V2RetroComputing/analog-hardware/V2A-Rev1/Bill-of-Materials.md

|Qty|Designator|Item|Package|Description|
|---|---|---|---|---|
|9x|C1-C9|16V 100nF X7R|0402|Multilayer Ceramic Capacitor|
|1x|C11|25V 10uF X5R|0805|Multilayer Ceramic Capacitor|
|1x|C10|25V 22uF X5R|0805|Multilayer Ceramic Capacitor|
|1x|U7|AZ1117H-3.3|SOT-223|Fixed 3.3V regulator|
|1x|D1|SS14F|SMAF|40V 550mV @ 1A Shottkey Barrier Diode|
|3x|R12,R13,R14|10K Ohm 100mW|0402|10K Ohm 100mW Thin Film Resistor|
|3x|R3,R6,R9|2K Ohm 100mW|0402|2K Ohm 100mW Thin Film Resistor|
|3x|R2,R5,R8|1K Ohm 100mW|0402|1K Ohm 100mW Thin Film Resistor|
|3x|R1,R4,R7|470 Ohm 100mW|0402|470 Ohm 100mW Thin Film Resistor|
|2x|R10,R11|47 Ohm 100mW|0402|47 Ohm 100mW Thin Film Resistor|
|4x|U1-U4|SN74LVC8T245DGVR|TVSOP-24|Texas Instruments SN74LVC8T245DGVR Level Translating Transceiver|
|1x|U5|ATF16V8C-5JX|PLCC-20|Microchip ATF16V8C PLD|
|1x|U6|Pico-W|Module|Raspberry Pi Pico or Pico-W module (no pins)|
|1x|J2|VGA Connector|HD-15|High-Density D-SUB 15 VGA Connector|
