V2RetroComputing/analog-hardware/V2A-Rev1/V2-Analog-Rev1.kicad_pcb

## KiCad design V2A-Rev1/V2-Analog-Rev1.kicad_pcb (2023-04-17)

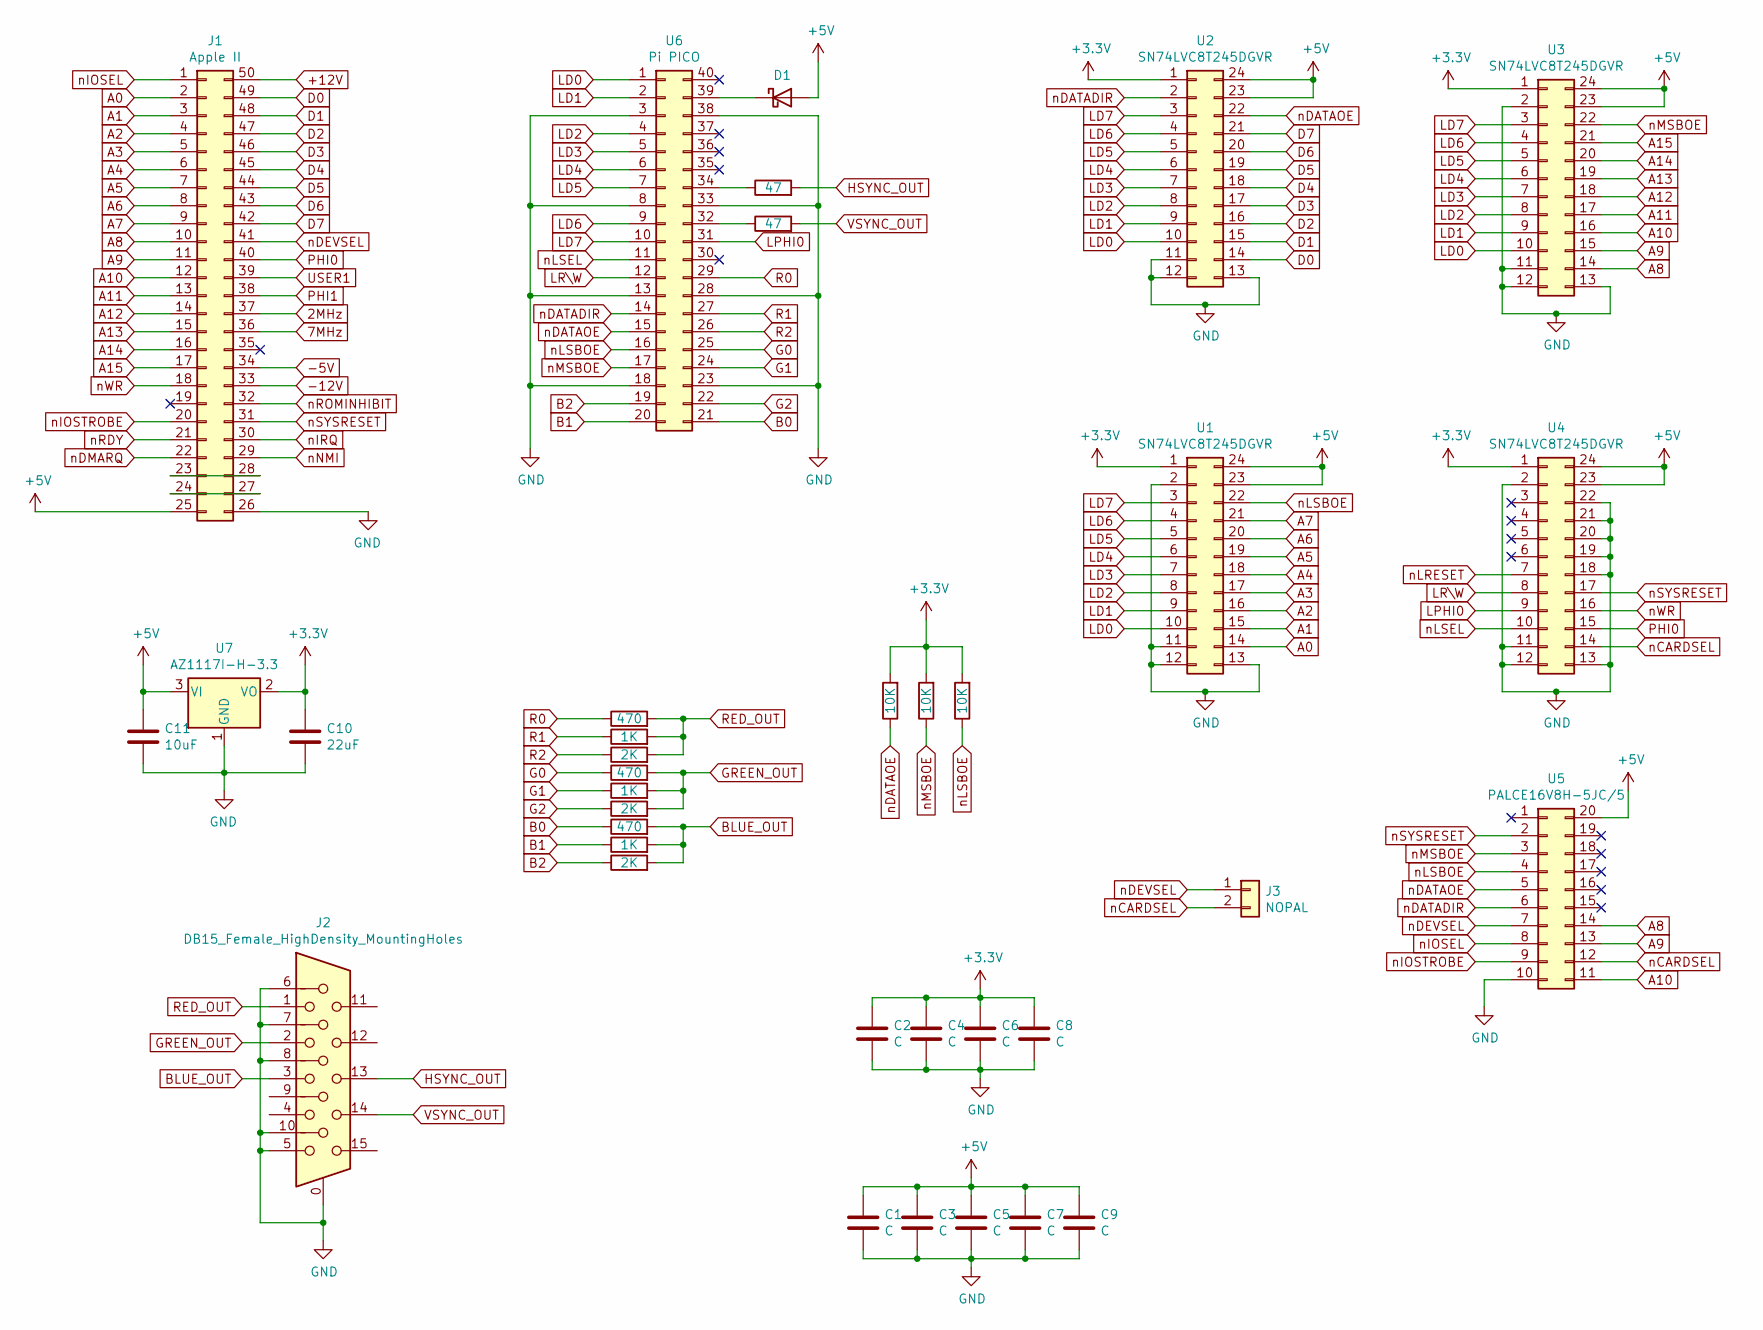
[picture p1: schematic V2-Analog-Rev1.sch]

Parts:
C1, C2, C3, C4, C5, C6, C7, C8, C9: C; C_0402_1005Metric_Pad0.74x0.62mm_HandSolder
C10: 22uF; C_0805_2012Metric_Pad1.18x1.45mm_HandSolder
C11: 10uF; C_0805_2012Metric_Pad1.18x1.45mm_HandSolder
D1: D_Schottky; D_SMA_Handsoldering
J1: Apple II; AppleII
J2: DB15_Female_HighDensity_MountingHoles; DSUB-15-HD_Female_Horizontal_P2.29x1.98mm_EdgePinOffset3.03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
J3: NOPAL; SolderJumper-2_P1.3mm_Open_TrianglePad1.0x1.5mm
R1, R4, R7: 470; R_0402_1005Metric_Pad0.72x0.64mm_HandSolder
R2, R5, R8: 1K; R_0402_1005Metric_Pad0.72x0.64mm_HandSolder
R3, R6, R9: 2K; R_0402_1005Metric_Pad0.72x0.64mm_HandSolder
R10, R11: 47; R_0402_1005Metric_Pad0.72x0.64mm_HandSolder
R12, R13, R14: 10K; R_0402_1005Metric_Pad0.72x0.64mm_HandSolder
U1, U2, U3, U4: SN74LVC8T245DGVR; TSSOP-24_4.4x5mm_P0.4mm
U5: PALCE16V8H-5JC/5; PLCC-20
U6: Pi PICO; DIP-40_W16.51mm_SMDSocket_LongPads
U7: AZ1117I-H-3.3; SOT-223-3_TabPin2

Connections:
2MHz: J1.37
7MHz: J1.36
+3V3: C2.1, C4.1, C6.1, C8.1, C10.1, R12.2, R13.2, R14.2, U1.1, U2.1, U3.1, U4.1, U7.2 (VO)
+5V: C1.1, C3.1, C5.1, C7.1, C9.1, C11.1, D1.2 (A), J1.25, U1.23, U1.24, U2.23, U2.24, U3.23, U3.24, U4.23, U4.24, U5.20, U7.3 (VI)
+12V: J1.50
-5V: J1.34
-12V: J1.33
A0: J1.2, U1.14
A1: J1.3, U1.15
A2: J1.4, U1.16
A3: J1.5, U1.17
A4: J1.6, U1.18
A5: J1.7, U1.19
A6: J1.8, U1.20
A7: J1.9, U1.21
A8: J1.10, U3.14, U5.14
A9: J1.11, U3.15, U5.13
A10: J1.12, U3.16, U5.11
A11: J1.13, U3.17
A12: J1.14, U3.18
A13: J1.15, U3.19
A14: J1.16, U3.20
A15: J1.17, U3.21
B0: R7.1, U6.21
B1: R8.1, U6.20
B2: R9.1, U6.19
BLUE_OUT: J2.3, R7.2, R8.2, R9.2
D0: J1.49, U2.14
D1: J1.48, U2.15
D2: J1.47, U2.16
D3: J1.46, U2.17
D4: J1.45, U2.18
D5: J1.44, U2.19
D6: J1.43, U2.20
D7: J1.42, U2.21
G0: R4.1, U6.25
G1: R5.1, U6.24
G2: R6.1, U6.22
GND: C1.2, C2.2, C3.2, C4.2, C5.2, C6.2, C7.2, C8.2, C9.2, C10.2, C11.2, J1.26, J2.0, J2.5, J2.6, J2.7, J2.8, J2.10, U1.2, U1.11, U1.12, U1.13, U2.11, U2.12, U2.13, U3.2, U3.11, U3.12, U3.13, U4.2, U4.11, U4.12, U4.13, U4.18, U4.19, U4.20, U4.21, U4.22, U5.10, U6.3, U6.8, U6.13, U6.18, U6.23, U6.28, U6.33, U6.38, U7.1 (GND)
GREEN_OUT: J2.2, R4.2, R5.2, R6.2
HSYNC_OUT: J2.13, R10.2
LD0: U1.10, U2.10, U3.10, U6.1
LD1: U1.9, U2.9, U3.9, U6.2
LD2: U1.8, U2.8, U3.8, U6.4
LD3: U1.7, U2.7, U3.7, U6.5
LD4: U1.6, U2.6, U3.6, U6.6
LD5: U1.5, U2.5, U3.5, U6.7
LD6: U1.4, U2.4, U3.4, U6.9
LD7: U1.3, U2.3, U3.3, U6.10
LPHI0: U4.9, U6.31
LR\W: U4.8, U6.12
unnamed: D1.1 (K), U6.39
unnamed: J1.23, J1.28
unnamed: J1.24, J1.27
unnamed: R10.1, U6.34
unnamed: R11.1, U6.32
PHI0: J1.40, U4.15
PHI1: J1.38
R0: R1.1, U6.29
R1: R2.1, U6.27
R2: R3.1, U6.26
RED_OUT: J2.1, R1.2, R2.2, R3.2
USER1: J1.39
VSYNC_OUT: J2.14, R11.2
nCARDSEL: J3.2, U4.14, U5.12
nDATADIR: U2.2, U5.6, U6.14
nDATAOE: R12.1, U2.22, U5.5, U6.15
nDEVSEL: J1.41, J3.1, U5.7
nDMARQ: J1.22
nIOSEL: J1.1, U5.8
nIOSTROBE: J1.20, U5.9
nIRQ: J1.30
nLRESET: U4.7
nLSBOE: R14.1, U1.22, U5.4, U6.16
nLSEL: U4.10, U6.11
nMSBOE: R13.1, U3.22, U5.3, U6.17
nNMI: J1.29
nRDY: J1.21
nROMINHIBIT: J1.32
nSYSRESET: J1.31, U4.17, U5.2
nWR: J1.18, U4.16

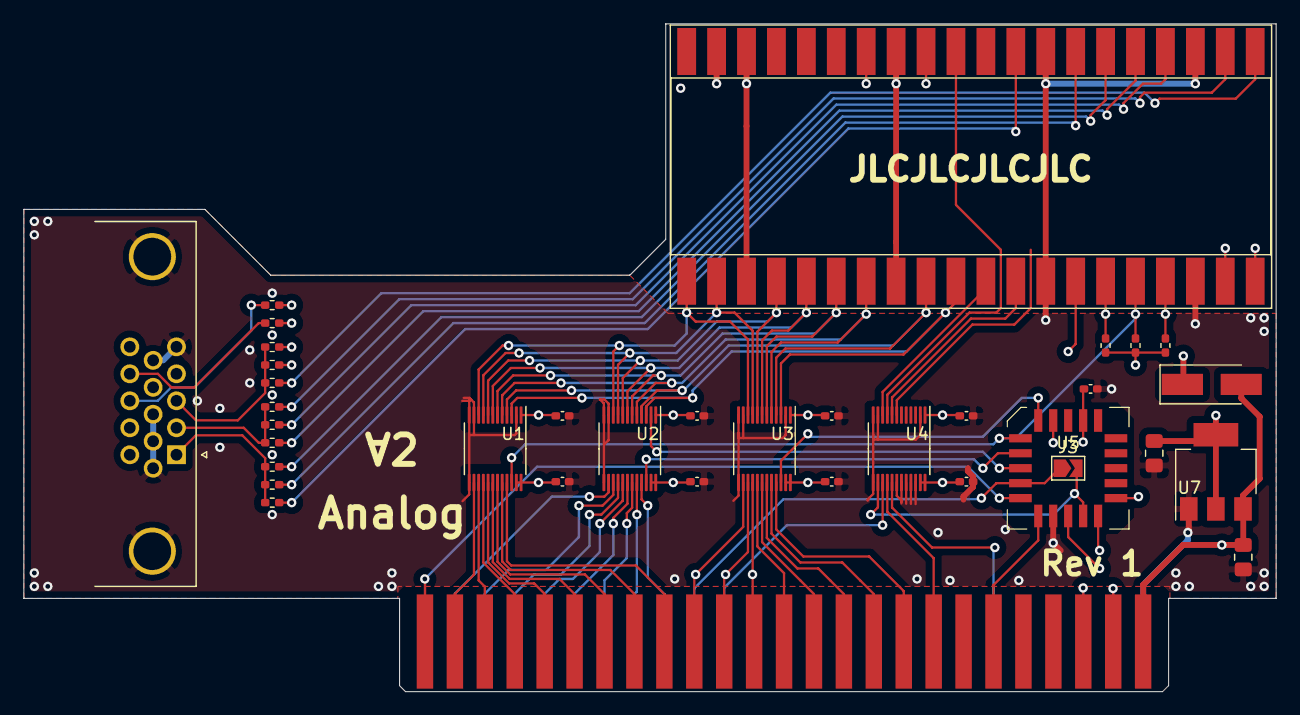
[picture p2: board V2-Analog-Rev1.kicad_pcb from above]

Board: 4 copper layers, 106.3 x 56.7 mm, 36 parts (0 on the bottom side), 68 nets.
