V2RetroComputing/analog-hardware/(commit log)

2023-04-17 V2 Analog Rev1 PCB Import
    [V2-Analog-Rev1-B_Cu.gbl, V2-Analog-Rev1-B_Mask.gbs, V2-Analog-Rev1-B_Paste.gbp, V2-Analog-Rev1-B_SilkS.gbo, V2-Analog-Rev1-Edge_Cuts.gm1, V2-Analog-Rev1-F_Cu.gtl, V2-Analog-Rev1-F_Mask.gts, V2-Analog-Rev1-F_Paste.gtp]
2023-04-17 Move Rev1 PCB files
    [V2-Analog-Rev1-B_Cu.gbl, V2-Analog-Rev1-B_Mask.gbs, V2-Analog-Rev1-B_Paste.gbp, V2-Analog-Rev1-B_SilkS.gbo, V2-Analog-Rev1-Edge_Cuts.gm1, V2-Analog-Rev1-F_Cu.gtl, V2-Analog-Rev1-F_Mask.gts, V2-Analog-Rev1-F_Paste.gtp]
